andyshinn/atopile-packages/README.md

# Andy's atopile Packages

## Packages

* `andyshinn/ebyte-e73`: [nRF52840 ble5.0 SMD 2.4GHz Nordic Wireless Module](https://www.cdebyte.com/products/E73-2G4M08S1C)
* `andyshinn/ebyte-e22`: [E22-900M30S 1W Long Range LoRa Module](https://www.cdebyte.com/products/E22-900M30S)
