andyshinn/atopile-packages/packages/ebyte-e73/parts/TE_CONMHF4-SMD-G-T/CONMHF4-SMD-G-T.step

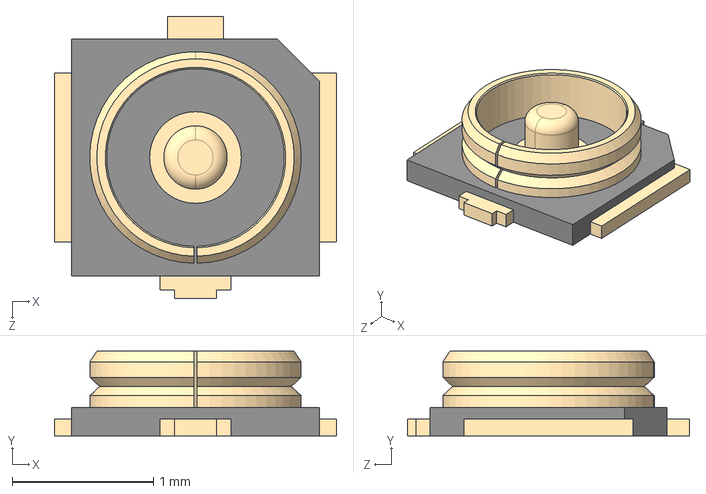
[picture p2: CAD file, 2025-09-27]
packages/ebyte-e73/parts/TE_CONMHF4-SMD-G-T/CONMHF4-SMD-G-T.step
2.00 x 0.6 x 2.00 mm
