andyshinn/atopile-packages/packages/jst-connectors/parts/B2B-PH-SM4-TB/B2B-PH-SM4-TB.step

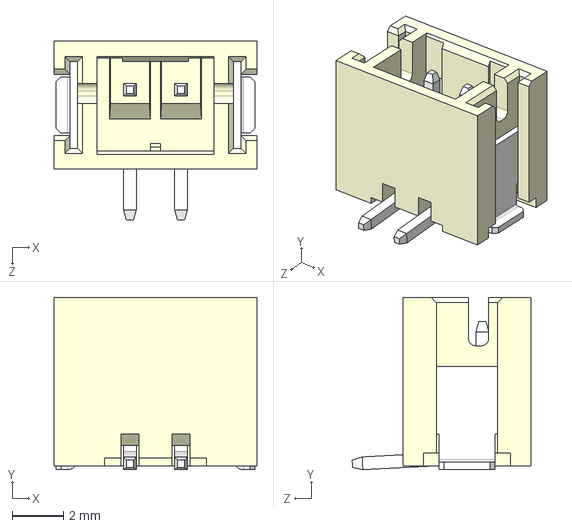
[picture p3: CAD file, 2025-09-29]
packages/jst-connectors/parts/B2B-PH-SM4-TB/B2B-PH-SM4-TB.step
7.95 x 6.75 x 7.00 mm
