andyshinn/atopile-packages/packages/jst-connectors/parts/S2B-PH-K-S/S2B-PH-K-S.step

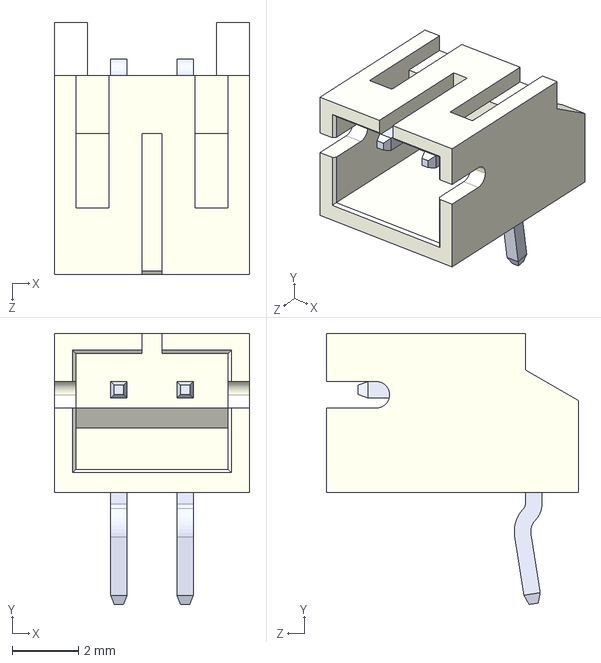
[picture p4: CAD file, 2025-09-29]
packages/jst-connectors/parts/S2B-PH-K-S/S2B-PH-K-S.step
5.90 x 8.18 x 7.60 mm
