andyshinn/atopile-packages/packages/ti-bq25798/parts/CCTC_TCC0402X5R104M250AT/C0402_L1.0-W0.5-H0.5.step

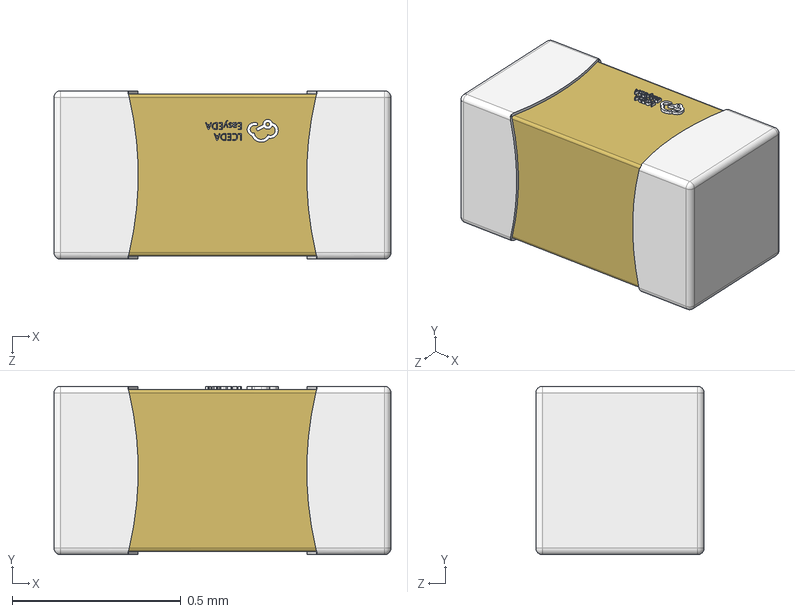
[picture p5: CAD file, 2025-09-27]
packages/ti-bq25798/parts/CCTC_TCC0402X5R104M250AT/C0402_L1.0-W0.5-H0.5.step
1.00 x 0.5 x 0.5 mm
