andyshinn/atopile-packages/packages/ti-bq25798/parts/Murata_Electronics_GRM21BC8YA106KE11L/C0805_L2.0-W1.3-H1.3.step

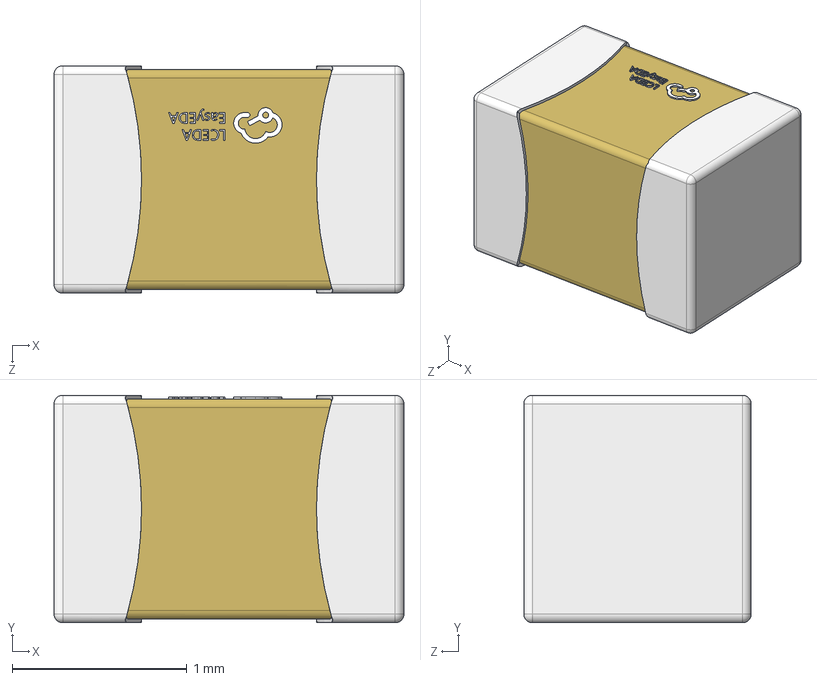
[picture p6: CAD file, 2025-09-27]
packages/ti-bq25798/parts/Murata_Electronics_GRM21BC8YA106KE11L/C0805_L2.0-W1.3-H1.3.step
2.00 x 1.30 x 1.30 mm
