andyshinn/atopile-packages/packages/ti-bq25798/parts/PANASONIC_ERJ2RKF3900X/R0402_L1.0-W0.5-H0.4.step

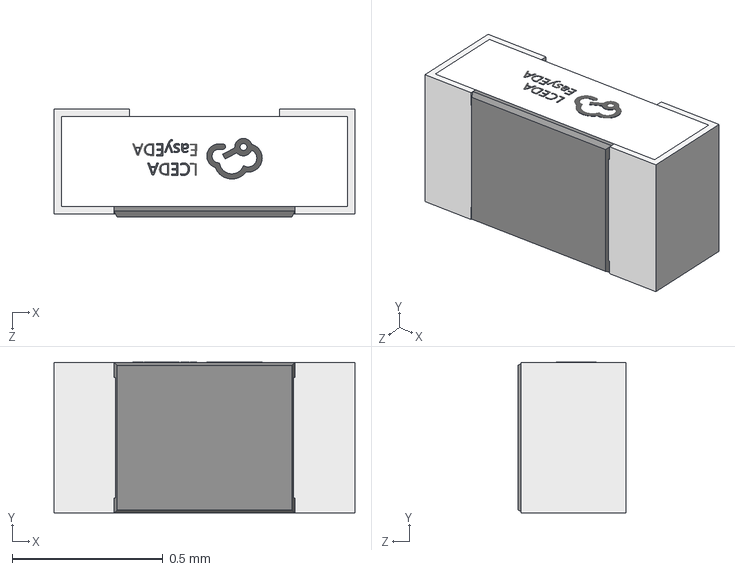
[picture p7: CAD file, 2025-09-27]
packages/ti-bq25798/parts/PANASONIC_ERJ2RKF3900X/R0402_L1.0-W0.5-H0.4.step
1.00 x 0.501 x 0.36 mm
