andyshinn/atopile-packages/packages/ti-bq25798/parts/Texas_Instruments_BQ25798RQMR/QFN-29_L4.0-W4.0-P0.40-TL-BQ25792RQMR.step

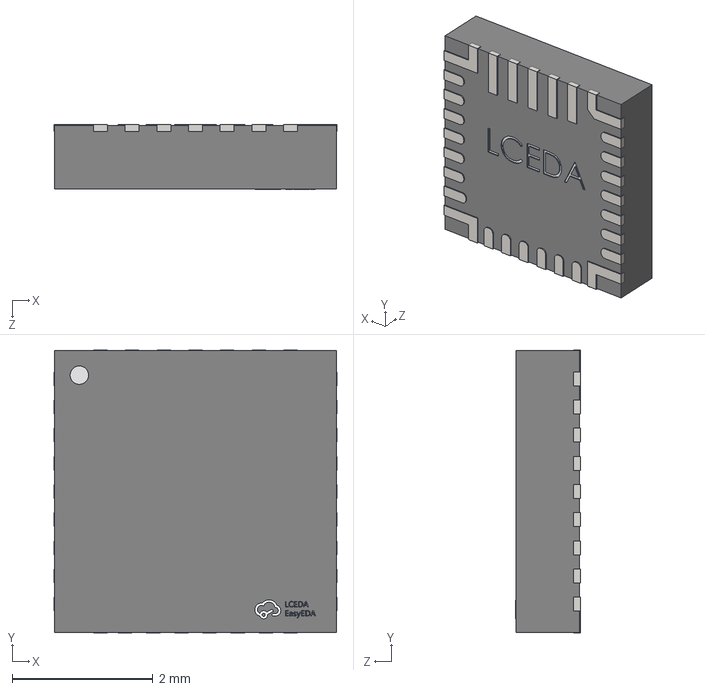
[picture p8: CAD file, 2025-09-29]
packages/ti-bq25798/parts/Texas_Instruments_BQ25798RQMR/QFN-29_L4.0-W4.0-P0.40-TL-BQ25792RQMR.step
4.02 x 4.02 x 0.93 mm
