andyshinn/atopile-packages/packages/ti-bq25895/parts/TDK_PS1240P02CT3/BUZ-TH_D12.5-H7.0-P5.0.step

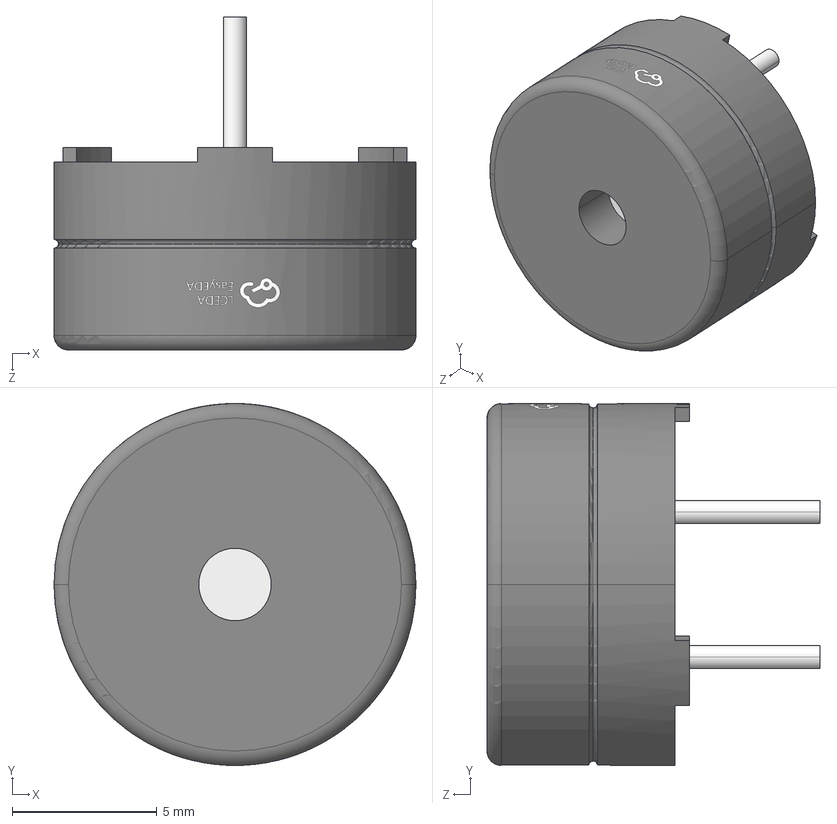
[picture p9: CAD file, 2025-09-28]
packages/ti-bq25895/parts/TDK_PS1240P02CT3/BUZ-TH_D12.5-H7.0-P5.0.step
12.5 x 12.5 x 11.5 mm
