andyshinn/atopile-packages/packages/ti-bq25895/parts/XTALTQ_BT0507BC3I287EN10B/OSC-SMD_10P-L7.0-W5.0-BL_BT507BC.STEP

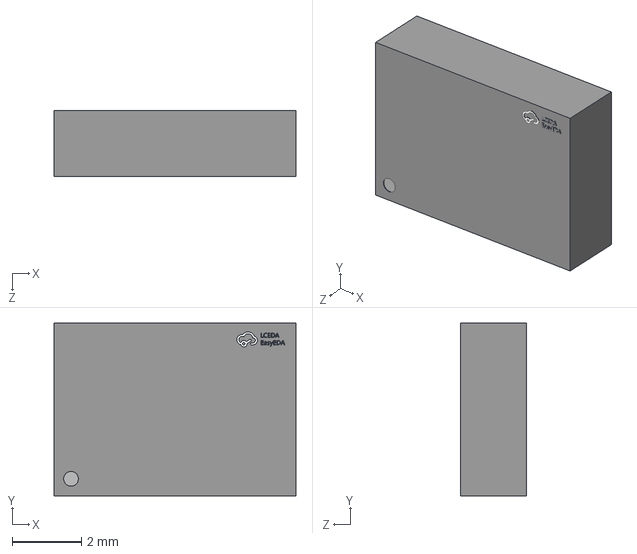
[picture p10: CAD file, 2025-09-28]
packages/ti-bq25895/parts/XTALTQ_BT0507BC3I287EN10B/OSC-SMD_10P-L7.0-W5.0-BL_BT507BC.STEP
7.00 x 5.00 x 1.92 mm
