andyshinn/atopile-packages/packages/ti-ina3221/parts/TI_INA3221/INA3221AIRGVT.step

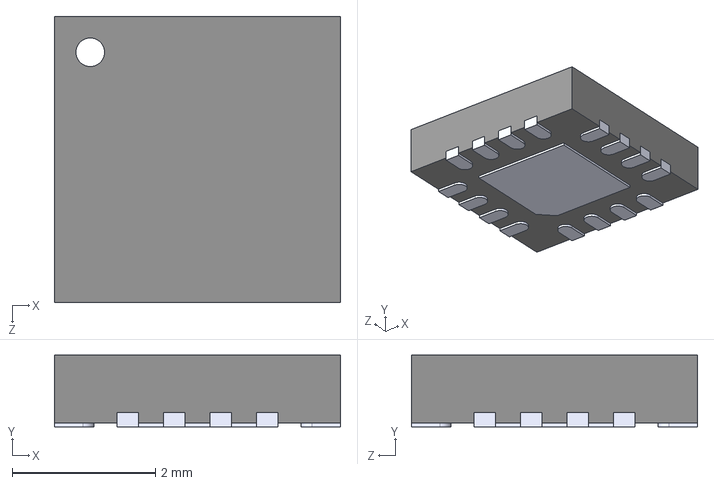
[picture p11: CAD file, 2025-09-29]
packages/ti-ina3221/parts/TI_INA3221/INA3221AIRGVT.step
4.00 x 1.00 x 4.00 mm
