andyshinn/atopile-packages/packages/ebyte-e73/parts/E73-2G4M08S1CX/E73-2G4M08S1CX - Board.dxf

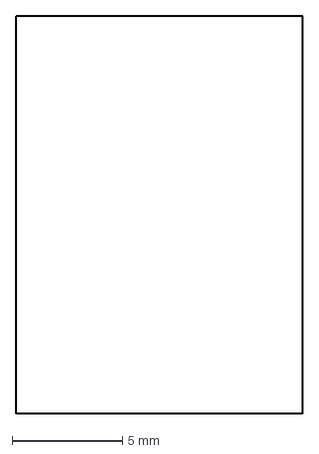
[picture p12: CAD file, 2025-09-27]
packages/ebyte-e73/parts/E73-2G4M08S1CX/E73-2G4M08S1CX - Board.dxf
13.0 x 18.0 mm
