andyshinn/atopile-packages/packages/ebyte-e73/parts/E73-2G4M08S1CX/E73-2G4M08S1CX - Pads Bottom.dxf

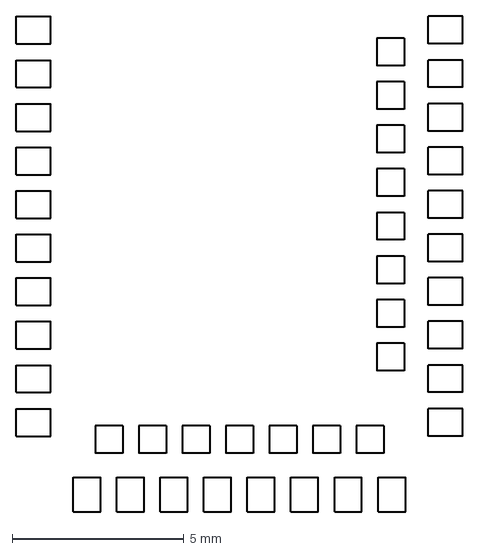
[picture p13: CAD file, 2025-09-27]
packages/ebyte-e73/parts/E73-2G4M08S1CX/E73-2G4M08S1CX - Pads Bottom.dxf
13.0 x 14.4 mm
