andyshinn/atopile-packages/packages/ti-bq25895/parts/TI_BQ25895RTWR/BQ25895RTWR.step

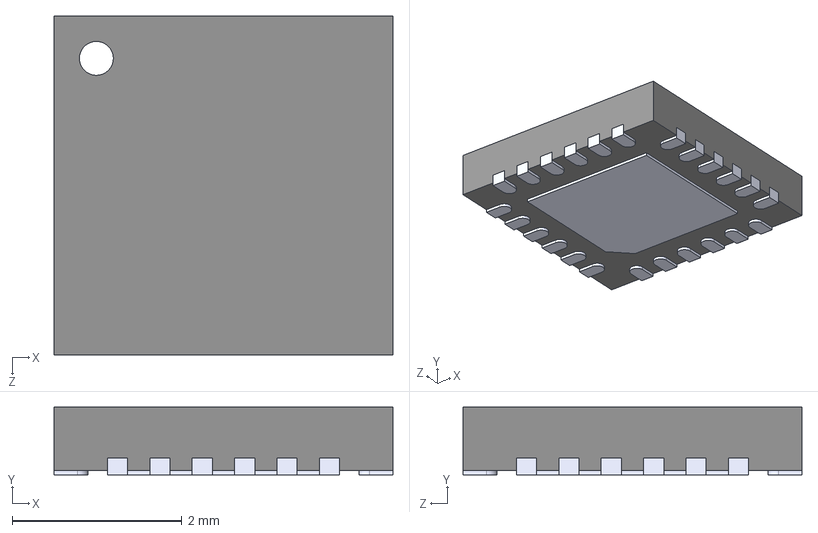
[picture p14: CAD file, 2025-09-28]
packages/ti-bq25895/parts/TI_BQ25895RTWR/BQ25895RTWR.step
4.00 x 0.8 x 4.00 mm
