andyshinn/atopile-packages/packages/ti-bq25798/layouts/default/default.kicad_pcb

## KiCad design packages/ti-bq25798/layouts/default/default.kicad_pcb (2025-09-29)

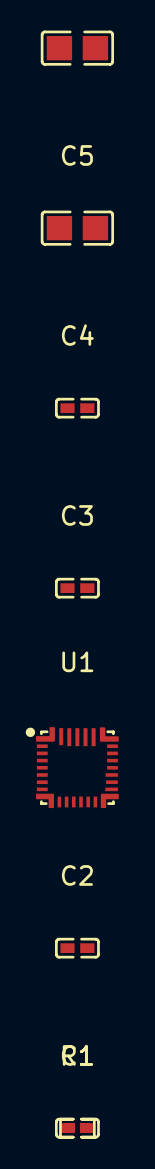
[picture p15: board packages/ti-bq25798/layouts/default/default.kicad_pcb from above]

Board: 2 copper layers, 8 parts (0 on the bottom side), 10 nets, no tracks yet.

Parts:
C1, C2: 100nF ±20% 25V X5R; C0402
C3: 100nF ±10% 6.3V X7R; C0402
C4: 1µF ±10% 6.3V X5R; C0402
C5: 10µF ±10% 25V X5R; C0805
C6: 10µF ±10% 35V; C0805
R1: 390Ω ±1% 100mW; R0402
U1: QFN-29_L4.0-W4.0-P0.40-TL-BQ25792RQMR

Connections:
GND: C3.2, C4.2, C5.2, C6.2, R1.2, U1.27
PROG: R1.1, U1.20
bootstrap1: C1.1, U1.4
bootstrap2: C2.1, U1.19
power_battery-VCC: U1.22, U1.23
power_regn-VCC: C3.1, C4.1, U1.5
power_system-VCC: C5.1, U1.25
power_vbus-VCC: C6.1, U1.2, U1.3
switch1: C1.2, U1.28
switch2: C2.2, U1.26
