andyshinn/atopile-packages/packages/ebyte-e73/layouts/usage/usage.kicad_pcb

## KiCad design packages/ebyte-e73/layouts/usage/usage.kicad_pcb (2025-09-28, an earlier design)

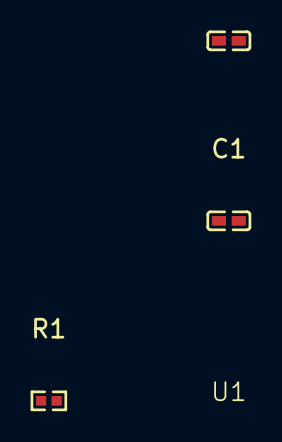
[picture p16: board packages/ebyte-e73/layouts/usage/usage.kicad_pcb from above]

Board: 2 copper layers, 4 parts (0 on the bottom side), 3 nets, no tracks yet.

Parts:
C1, C2: 100nF ±10% 16V X7R; C0402
R1: 10kΩ ±1% 62.5mW; R0402
U1: E73-2G4M08S1CX

Connections:
GND: C1.2, C2.2, U1.5, U1.21, U1.24
SWD_RESET: R1.2, U1.26
power_vdh-VCC: C1.1, C2.1, R1.1, U1.19, U1.23
