andyshinn/atopile-packages/packages/ti-bq25895/layouts/default/default.kicad_pcb

## KiCad design packages/ti-bq25895/layouts/default/default.kicad_pcb (2025-09-28, an earlier design)

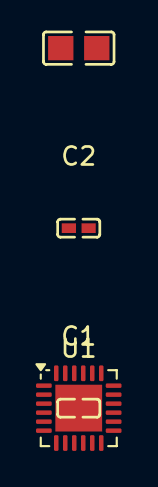
[picture p17: board packages/ti-bq25895/layouts/default/default.kicad_pcb from above]

Board: 2 copper layers, 4 parts (0 on the bottom side), 3 nets, no tracks yet.

Parts:
C1: 100nF ±10% 6.3V X7R; C0402
C2: 1µF ±10% 6.3V X5R; C0402
C3: 10µF ±10% 25V X5R; C0805
U1: WQFN-24-1EP_4x4mm_P0.5mm_EP2.6x2.6mm

Connections:
GND: C1.2, C2.2, C3.2, U1.10, U1.19
power_regn-VCC: C1.1, C2.1, U1.2
power_vbus-VCC: C3.1, U1.5
