andyshinn/atopile-packages/packages/ebyte-e22/layouts/default/default.kicad_pcb

## KiCad design packages/ebyte-e22/layouts/default/default.kicad_pcb (2025-09-28, an earlier design)

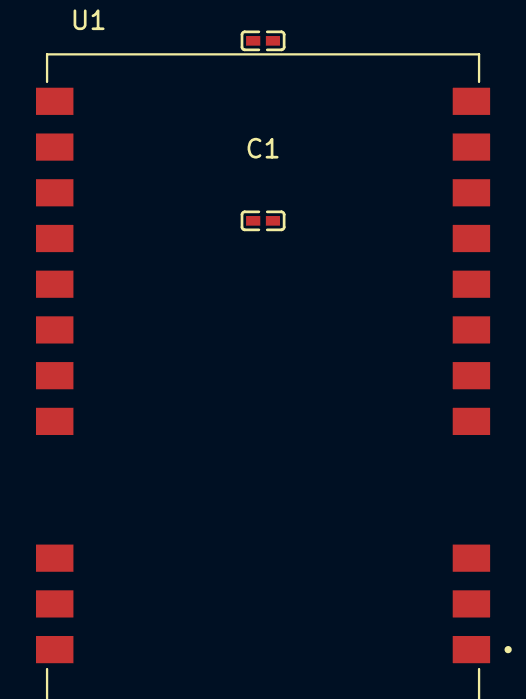
[picture p18: board packages/ebyte-e22/layouts/default/default.kicad_pcb from above]

Board: 2 copper layers, 3 parts (0 on the bottom side), 2 nets, no tracks yet.

Parts:
C1, C2: 100nF ±10% 16V X7R; C0402
U1: E22-900M30S

Connections:
GND: C1.2, C2.2, U1.1, U1.2, U1.3, U1.4, U1.5, U1.11, U1.12, U1.20, U1.22
VCC: C1.1, C2.1, U1.9, U1.10
