andyshinn/atopile-packages/packages/ebyte-e22/layouts/usage/usage.kicad_pcb

## KiCad design packages/ebyte-e22/layouts/usage/usage.kicad_pcb (2025-09-28, an earlier design)

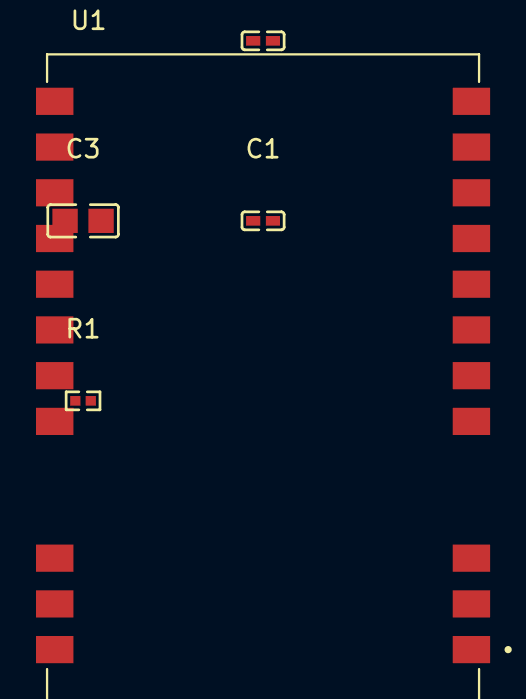
[picture p19: board packages/ebyte-e22/layouts/usage/usage.kicad_pcb from above]

Board: 2 copper layers, 5 parts (0 on the bottom side), 3 nets, no tracks yet.

Parts:
C1, C2: 100nF ±10% 16V X7R; C0402
C3: 10µF ±10% 25V X5R; C0805
R1: 10kΩ ±1% 62.5mW; R0402
U1: E22-900M30S

Connections:
GND: C1.2, C2.2, C3.2, U1.1, U1.2, U1.3, U1.4, U1.5, U1.11, U1.12, U1.20, U1.22
VCC: C1.1, C2.1, C3.1, R1.1, U1.9, U1.10
reset-line: R1.2, U1.15
