andyshinn/atopile-packages/packages/ti-bq25895/layouts/example/example.kicad_pcb

## KiCad design packages/ti-bq25895/layouts/example/example.kicad_pcb (2025-09-28, an earlier design)

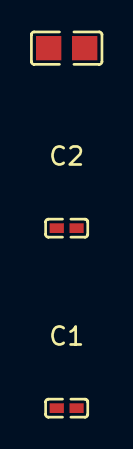
[picture p20: board example.kicad_pcb from above]

Board: 2 copper layers, 3 parts (0 on the bottom side), 2 nets, no tracks yet.

Parts:
C1: 100nF ±10% 6.3V X7R; C0402
C2: 1µF ±10% 6.3V X5R; C0402
C3: 10µF ±10% 25V X5R; C0805

Connections:
GND: C1.2, C2.2, C3.2
power_regn-VCC: C1.1, C2.1
