andyshinn/atopile-packages/(commit log)

2025-09-27 compile E22
    [C0402_L1.0-W0.5-H0.5.step, C0805_L2.0-W1.3-H1.3.step, R0402_L1.0-W0.5-H0.4.step, default.kicad_pcb, usage.kicad_pcb]
2025-09-28 adding has_part_picked trait to all
    [R0402_L1.0-W0.5-H0.4.step, default.kicad_pcb, usage.kicad_pcb]
2025-09-29 JST-PH 2pin
    [B2B-PH-SM4-TB.step, S2B-PH-K-S.step, default.kicad_pcb, example.kicad_pcb, jst_ph_2pin_smt.kicad_pcb, jst_ph_2pin_th.kicad_pcb, usage.kicad_pcb]
